decrazyo/fdxb/(commit log)

2024-06-23 Update README.md
    update materials lists
2024-12-14 README: capacitors are in Farads, not Henries
